hugo38rodrigues/GazSensorRobot/datasheet/MQ-2/mq2-arduino-curve-reading-rs-r0-ratio-calibration.png

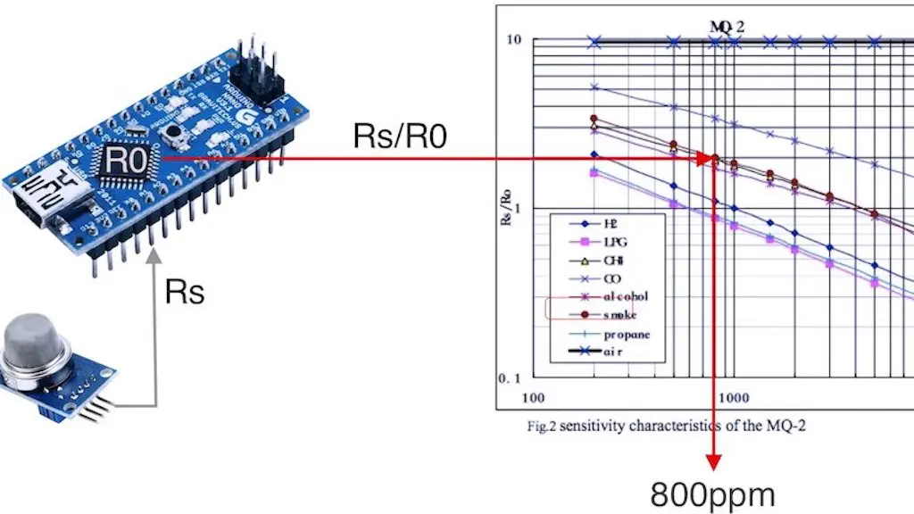
datasheet/MQ-2/mq2-arduino-curve-reading-rs-r0-ratio-calibration.png
