hugo38rodrigues/GazSensorRobot/pictures/20201014_091613.jpg

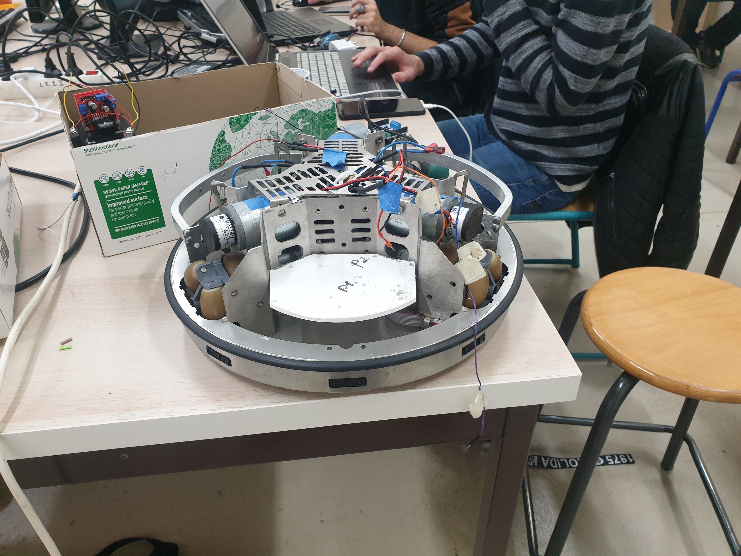
pictures/20201014_091613.jpg
