hugo38rodrigues/GazSensorRobot/Doc/Rapport_projet_2020_2021.docx

Rodrigues Hugo

Neyret Anthony

# Rapport de projet de fin d’étude

# Robot détecteur de Gaz

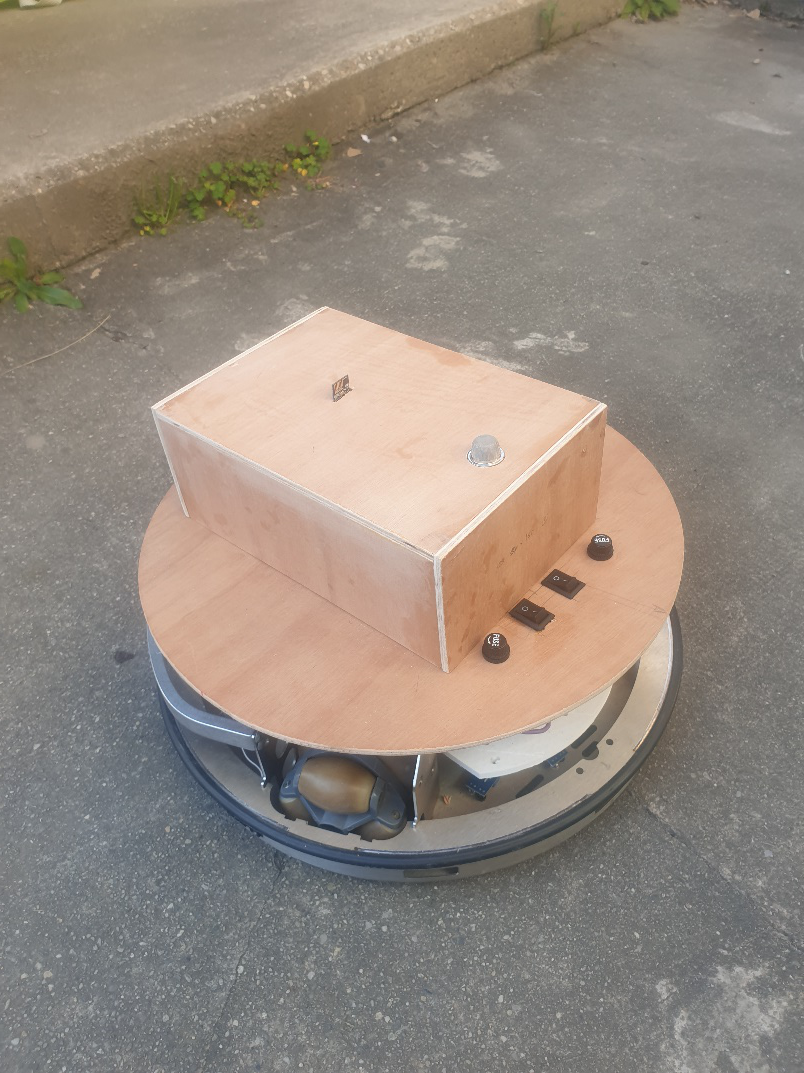
[picture p3: figure]

IUT GEII Le Creusot Année scolaire 2020 – 2021

# 1 Cahier des charges

## 1.1 Objectifs

L’objectif de ce projet a été de transformer un robot construit précédemment à l’IUT en un robot capable de se déplacer dans un environnement connu et détecter quelque chose.

Nous avons complété le cahier des charges avec les fonctions suivantes :

- Créer un robot mobile ayant pour but de trouver l’origine d’un gaz sur un terrain connu et le signaler à l’utilisateur par un mail.
- Le robot doit être dérivé d’une base de robot préexistant et fourni par l’IUT.
- Le robot sera alimenté par batterie (2 x 12V)
- Il devra disposer d’un mécanisme de détection de gaz et/ou fumée
- Il devra utiliser un système Wi-Fi pour transmettre l’information d’alerte via un mail.
- Il devra suivre un chemin prédéfini par une bande noire au sol.
- Il devra transmettre une photo/vidéo via une caméra de la zone de détection de gaz/fumées.
- Il devra stopper son parcours dès qu’il arrive dans sa zone de stockage (fin de parcours)
- Il devra stopper son parcours s’il rencontre un obstacle.

## 1.2 Présentation du robot

Il s’agit d’un robot construit à l’IUT les années précédentes avec :

- une armature en acier,
- trois roues avec moteurs disposées en étoile,
- deux supports de batterie,
- un capteur de contact digital présent sur tout le tour du robot,
- des capteurs de proximités analogiques positionnés autour du robot (9 capteurs).

Les trois moteurs fonctionnent et les roues tournent correctement en sens horaire et antihoraire suivant la tension d’alimentation (positive/négative).

Les deux batteries sont opérationnelles et disposent d’une tension de 12V chacune.

Note : Les batteries ne sont pas rechargeables.

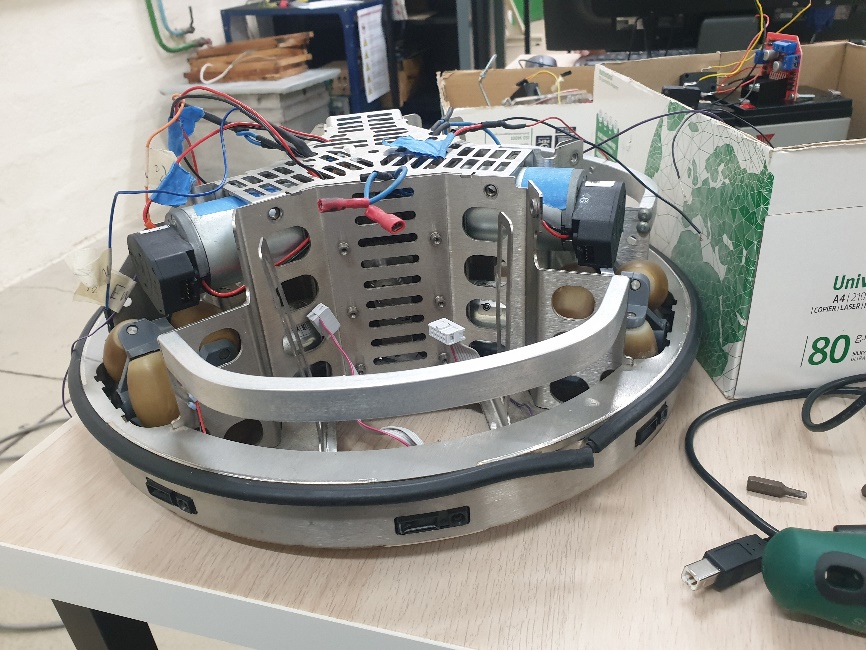
[picture p4: figure]

## 1.3 Matériel mis à disposition

L’IUT a fourni le matériel suivant pour la réalisation du robot :

- Le robot
- Les deux batteries de 12V
- Un microcontrôleur de type Arduino UNO
- Une caméra de type OpenMV H7
- Des câbles

## 1.4 Matériel acheté pour la réalisation

Afin de permettre la réalisation du projet, le matériel suivant a été acheté en complément, son utilisation sera détaillée par la suite :

- Un capteur de détection de gaz/fumée
- Trois capteurs digitaux de proximité à LED
- Un démultiplexeur de type 74HC595
- Des borniers (Dupont et à vis)
- Des câbles

# 2 Planning

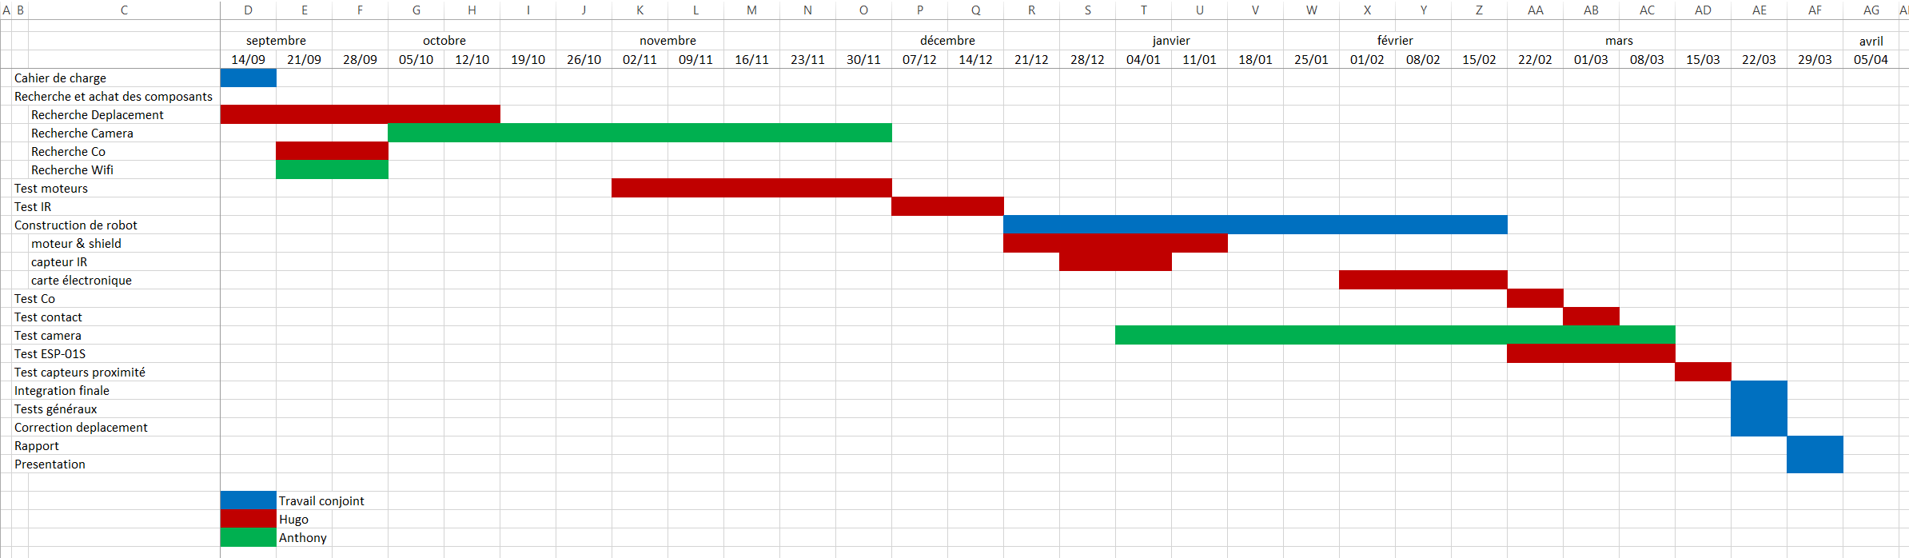
[picture p5: figure]

# 3 La conception

## 3.1 Les fonctions mises en œuvre

Les différentes fonctions mises en œuvre pour le robot sont :

- Le déplacement
- La détection de gaz/fumées
- La détection d’obstacles
- L’émission d’un mail d’avertissement en cas de détection de gaz/fumées.
- La gestion d’une zone de stockage

Voici une vue globale du montage réalisé :

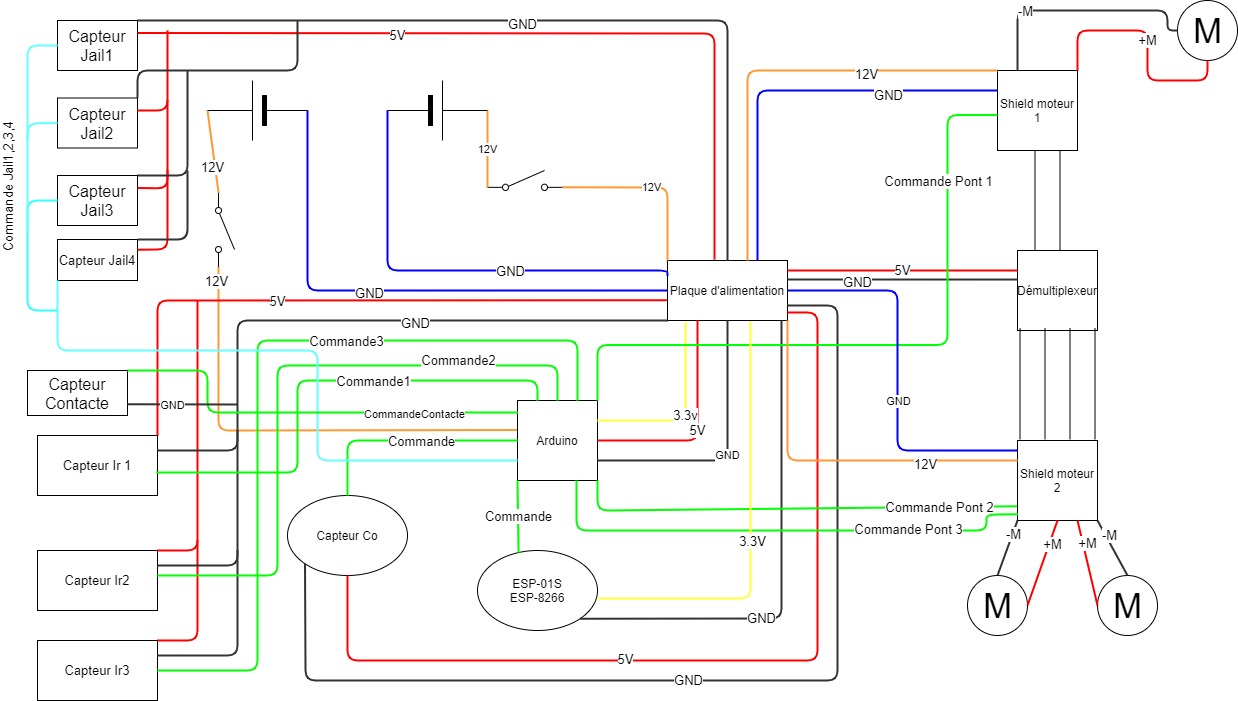
[picture p6: figure]

En orange, on distingue les composants en charge de gérer le déplacement, en jaune la détection de gaz, en vert la détection de contact, en violet l’envoi de mail et en bleu la zone de stockage.

### 3.1.1 La gestion du déplacement

Le robot est constitué de trois roues montées en étoile dont on pilote le sens la vitesse de rotation pour guider le robot.

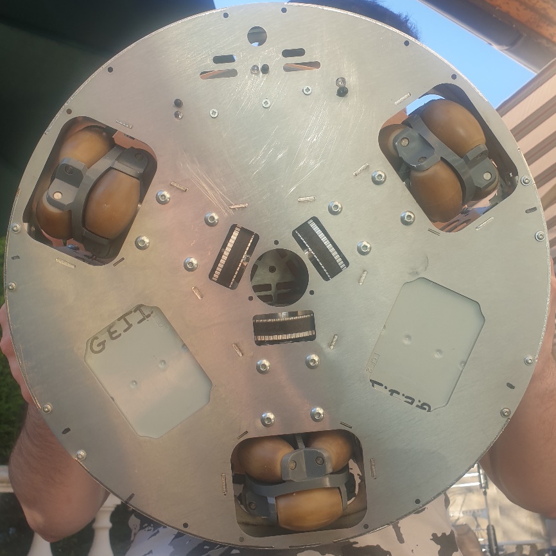
[picture p7: figure]

Le tableau suivant récapitule les actions à effectuer sur le robot pour gérer son déplacement :

| Roue 1 (avant droit) | Roue 2 (avant gauche) | Roue 3 (arrière)
Avancer | Sens horaire | Sens antihoraire | Stop
Ajuster à droite | Sens horaire | Sens antihoraire | Sens antihoraire
Ajuster à gauche | Sens horaire | Sens antihoraire | Sens horaire
Tourne à droite | Sens antihoraire | Sens antihoraire | Sens antihoraire
Tourne à gauche | Sens horaire | Sens horaire | Sens horaire
Stop | Stop | Stop | Stop

Afin de piloter les moteurs et gérer la trajectoire du robot, on a choisi d’utiliser des shields moteur et des capteurs Infra Rouge digitaux placés dans le nez du robot pour détecter la ligne noire.

Les capteurs IR digitaux sont détaillés dans le chapitre 4.4.1.

Pour choisir les bons cas pour suivre la ligne on a dressé un tableau logique des entrées et sorties inversés :

Entrées | | | Sorties
Capteur Gauche | Capteur Centre | Capteur Droit | D | G | Ad | Ag | Stop | Av
1 | 1 | 1 | 0 | 0 | 0 | 0 | 1 | 0
1 | 1 | 0 | 1 | 0 | 0 | 0 | 0 | 0
1 | 0 | 1 | 0 | 0 | 0 | 0 | 0 | 1
1 | 0 | 0 | 0 | 0 | 1 | 0 | 0 | 1
0 | 1 | 1 | 0 | 1 | 0 | 0 | 0 | 0
0 | 1 | 0 | x | x | x | x | x | x
0 | 0 | 1 | 0 | 0 | 0 | 1 | 0 | 1
0 | 0 | 0 | x | x | x | x | x | x

Les « 0 » représentent quand les capteurs IR détectent la ligne noire (absence de détection).

- D/G représente une rotation droite/gauche (le robot tourne sur place)
- Ad/Ag représente un ajustement droite / gauche (le robot continue d’avancer mais tourne en même temps grâce à la roue arrière)
- Stop : arrêt des moteurs
- Av : représente une avance du robot

### 3.1.2 Les Moteurs

Les moteurs intégrés dans le robot sont des GR42X25 :

- Tension nominale : 24V,
- Un courant nominal de 0.86A.
- Puissance nominale de 14.3W.

Nous avant fait le choix d’alimenter les moteurs en 12V afin de limiter la consommation sur les batteries (répartition de charges sur les deux batteries) et réduire la vitesse des moteurs.

### 3.1.3 Les Shields L298N

Afin de piloter les moteurs et gérer le sens de rotation, on a choisi de mettre en œuvre des shields moteur de type L298N qui intègrent un double pont en H.

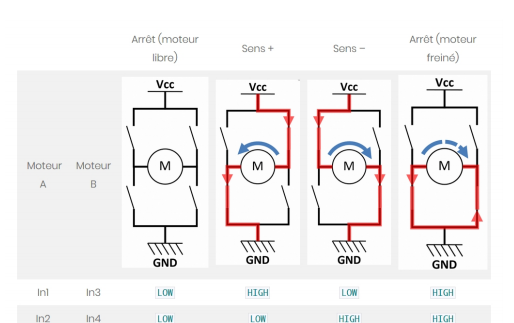
[picture p8: figure]

L’activation d’un pont en H (broches Enable ENA et ENB) ainsi que le sens de rotation des moteurs (broches In1 à In4) sont pilotés par l’Arduino. Ces broches d’activation sont des entrées PWM permettant ainsi de contrôler la vitesse de rotation du moteur.

On justifie le choix d’avoir pris des Shields par le fait que l’Arduino ne peut pas alimenter seul les moteurs (sortie Arduino 5V et max 40 mA).

Les broches permettant de gérer le sens de rotation sont câblées à l’Arduino par l’intermédiaire d’un démultiplexeur.

Les Shields sont alimentés par les batteries via une plaque d’alimentation en 12 V.

### 3.1.4 Démultiplexeur 74HC595

Lors de la conception, nous nous sommes rendu compte que nous allions manquer de pins digitales sur l’Arduino pour piloter les 2 Shields. Après réflexion et recherche sur Internet on a décidé d’opter pour l’ajout d’un démultiplexeur 74HC595N pour étendre le nombre de pins digitales disponibles plutôt que de rajouter un autre Arduino.

Le 74HC595 est en fait un registre à décalage qui reçoit en entrée une information sous la forme d’un champ de bits (codé sur 8 bits) et qui le transforme en 8 signaux parallèles (état haut ou bas) sur ses sorties Qn.

L’alimentation du démultiplexeur se fait par la plaque d’alimentation en 5V.

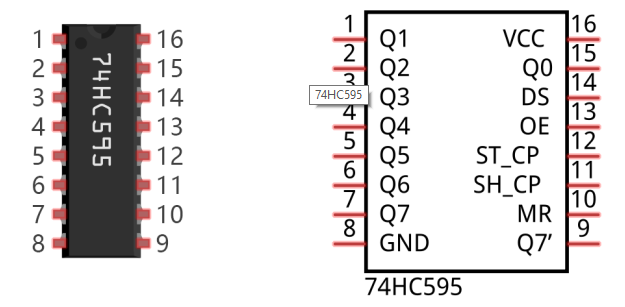
[picture p9: figure]

L’entrée des données issues de l’Arduino permettant de commander les sorties se trouve sur Serial Data Input (DS).

La modification de l’état de sortie du registre nécessite d’activer le Latch (ST_CP) que l’on passe à l’état bas. Une fois le registre reconfiguré, il est remis à l’état haut pour activer les sorties du registre.

Afin de savoir qu’une nouvelle donnée est disponible en lecture (sur la broche DS), le 74HC595 a besoin d’un front montant d’horloge Clock (SH_CP) qui est fournie par l’Arduino.

Une fois le Latch remis à l’état haut, les pins de sorties sont à l’image du champ de bits fourni en entrée sur la pin DS.

Pour chaque moteur, le sens de rotation horaire est codé sous la forme 01, alors que le sens antihoraire est codé sous la forme 10.

La pin Q0 n’est pas utilisée ainsi que la pin Q7 et sont mises à 0. Les valeurs pour la pin DS obtenues après un OU logique sont :

| M1 | M2 | M3 | DS
Avancer | 0b00100000 | 0b00010000 | 0b00000000 | 0b00110000
AjusteGauche | 0b00100000 | 0b00010000 | 0b00000010 | 0b00110010
AjusteDroite | 0b00100000 | 0b00010000 | 0b00000100 | 0b00110100
Gauche | 0b00100000 | 0b00001000 | 0b00000010 | 0b00101010
Droite | 0b01000000 | 0b00010000 | 0b00000100 | 0b01010100
Stop | N/A | N/A | N/A | N/A

## 3.2 Camera Open MV H7

La caméra utilisée est une caméra de chez OpenMV model H7, fournie avec le robot.

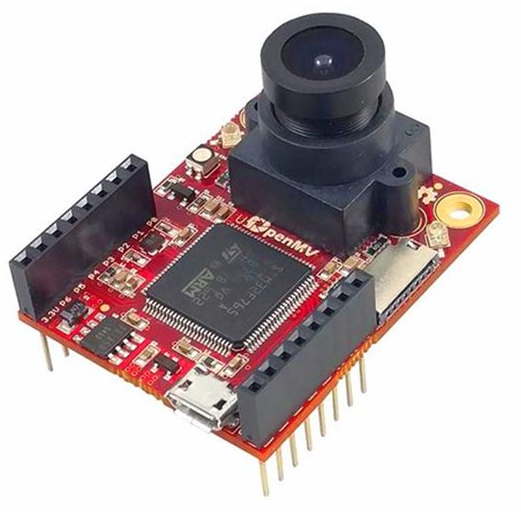
[picture p10: figure]

On avait pour but de faire communiquer la caméra et l’Arduino. Ce dernier devait détecter du gaz et demander à la caméra de prendre une photo, puis l’Arduino aurait récupéré cette photo pour l’envoyer par mail en Wifi.

Puis nous nous sommes orientés vers un envoi de la photo directement depuis la caméra grâce à un module Wifi. Malheureusement, la caméra OpenMV H7 ne supporte pas d’autres modules Wifi que l’extension Shield Wifi fourni par OpenMV. Il nous a donc été impossible de pouvoir transmettre les photos prises par la caméra avec le module Wifi ESP8266.01S que nous avions acheté.

Nous nous sommons penchés trop tard sur la fonction d’envoi des photos depuis la caméra et le tarif du Shield (30€) ainsi que les délais de livraison à quelques semaines de la fin du projet nous ont obligé à supprimer cette fonctionnalité.

Toutefois, pour régler ce problème, on a testé deux solutions pour le projet :

- La première solution consistait à utiliser notre module ESP-01S branché sur l’OpenMV et faire communiquer les deux. OpenMV fournit des librairies qui permettent de faire du transfert de données via des bus UART, I2C ou SPI qui auraient pu nous permettre de transférer les images octets par octets à l’Arduino ou à l’ESP-01S. Solution assez complexe et probablement impossible du fait du peu de mémoire disponible sur l’ESP.
- La deuxième solution a été d’acheter une caméra Arduino OV7670, mais nous avons trouvé très peu d’exemples de mise en œuvre ou alors avec d’autres version d’Arduino (la librairie Adafruit OV7670 n'est pas compatible avec un Arduino UNO mais avec un µcontroleur de gamme SADM et pas ATM32 comme le UNO).

Donc les deux solutions n’étaient pas viables et nous avons finalement choisit d’utiliser notre module ESP-01S pour envoyer uniquement un mail en cas de détection de gaz par le capteur MQ2.

## 3.3 Communication

Le module communication a été réalisé à l’aide d’un ESP8266-01S, qui a été programmé via les liaisons RX/TX de l’Arduino. Le code utilisé sur l’ESP-01 est disponible dans l’annexe 0.

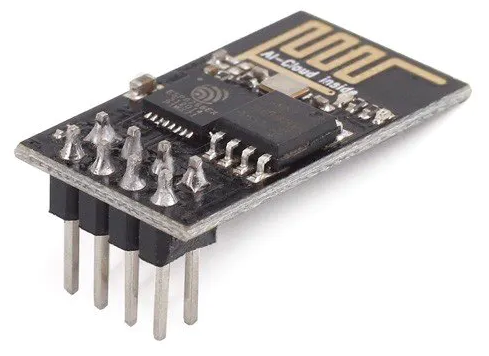
[picture p11: figure]

L’ESP8266-01S est activé par l’Arduino via la pin IO2. Lorsque l’ESP8266-01S est activé, il envoie un mail pour signaler que le robot a détecté du gaz.

Il est alimenté en 3.3V et cela passe également par la carte d’alimentation.

## 3.4 Les capteurs

A l’origine, le robot était équipé de deux types des capteurs différents :

- Un capteur digital de contact.
- 9 capteurs analogiques Infra Rouge de proximité.

En complément, nous avons ajouté au robot un capteur de gaz MQ-2 pour gérer la détection des gaz/fumées et 3 capteurs Infra Rouge digitaux pour détecter la ligne noire.

Les capteurs analogiques Infra Rouge sont utilisés pour détecter la zone de stockage du robot et le capteur de contact quant à lui est utilisé pour détecter un possible obstacle sur le chemin tracé.

### 3.4.1 Capteurs Infra Rouge de suivi de ligne

Afin de pouvoir effectuer le suivi de la ligne noire, nous avons acheté trois capteurs Infra Rouge digitaux pour Arduino.

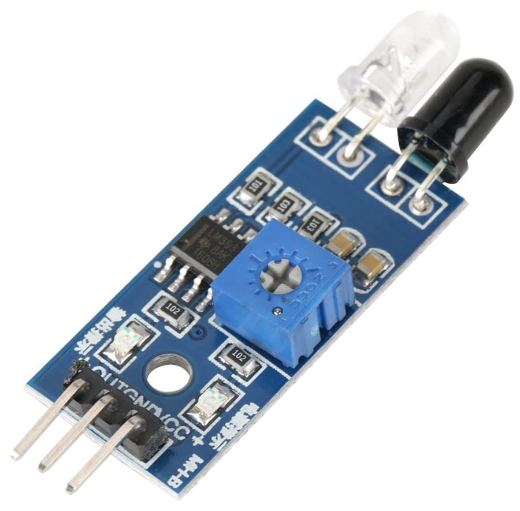
[picture p12: figure]

Ces capteurs fonctionnent sur une alimentation de 5V et son état est retourné sur une pin digitale à l’état haut en cas de détection.

La distance de mesure est ajustable à l’aide du potentiomètre intégré et la distance de détection est relativement faible, permettant ainsi leur usage sous le robot pour détecter la ligne noire.

La détection de la ligne noire est en fait une non-détection car l’Infra Rouge est absorbé par la couleur noire et donc non retournée au capteur qui ne voit pas d’obstacle.

### 3.4.2 Capteur de gaz

Afin de pouvoir détecter les gaz/fumées, nous avons acheté un capteur de gaz de type MQ-2.

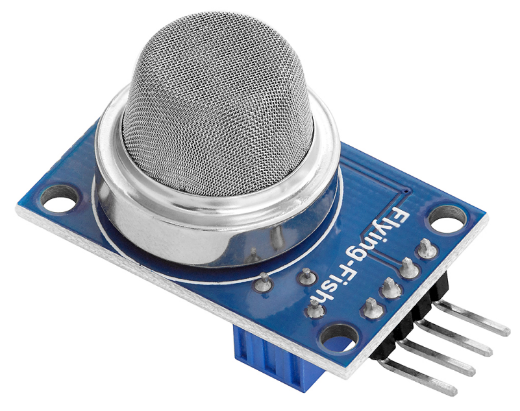
[picture p13: figure]

On a décidé de prendre ce capteur car sa gamme de détection nous offre des choix plutôt variés :


Comme on le voit sur le graphique, plusieurs types de gaz différents peuvent être détectés. A des fins de simplifications pour le projet, nous nous sommes contenté de lire la valeur renvoyée par le capteur sans mettre en œuvre la partie calibration et analyse du module (un exemple est disponible sur ce site : https://projetsdiy.fr/utiliser-detecteur-gaz-fumees-mq2-code-arduino/).

Le capteur dispose de deux sorties : une digitale qui renvoie un état haut en cas de détection basée sur un potentiomètre de réglage du seuil et une analogique qui renvoie simplement la valeur mesurée.

Nous avons fait le choix de prendre la sortie analogique car nous souhaitions contrôler un niveau de seuil de 300 ppm pour le CO, afin de préparer le terrain en vue de la mise en œuvre de la partie calibration/analyse. Nous avons fixé une valeur moyenne de détection en cas de présence de gaz de type briquet (butane) pour le projet.

### 3.4.3 Capteur de la zone de stockage :

Les capteurs Infrarouge montés d’origine sur le robot sont des capteurs analogiques de type GP2Y0A41SK0F. Ils répondent à la courbe de détection suivante :

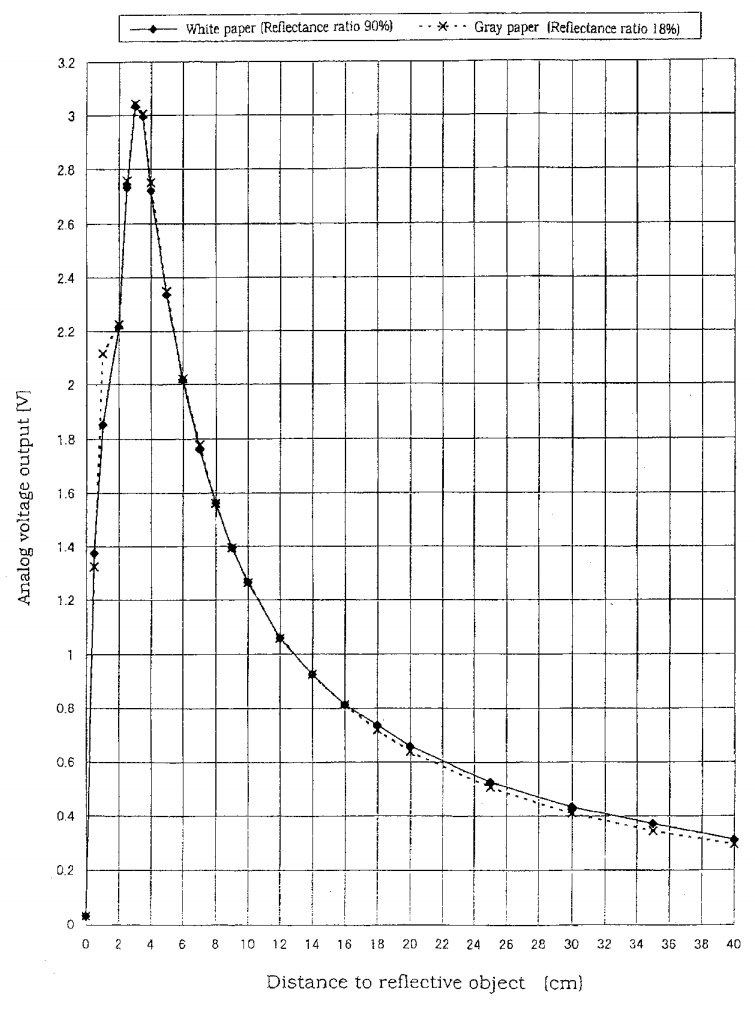
[picture p14: figure]

On distingue dans la courbe une zone d’incertitude liée à une trop grande proximité d’un obstacle avec le capteur. On a donc choisi de mettre un seuil de déclenchement à 18 cm, ce qui correspond à environ 0.7 V en sortie du capteur. C’est d’ailleurs pour cette raison que nous n’avons pas pu les utiliser comme capteurs de suivi de la ligne noire, la distance robot-sol étant de moins de 2 cm.

Afin de réutiliser les capteurs infra-rouges fournis, on a décidé de gérer une zone de stockage pour que le robot vienne se stationner lorsqu’il a fini son tour de ronde :

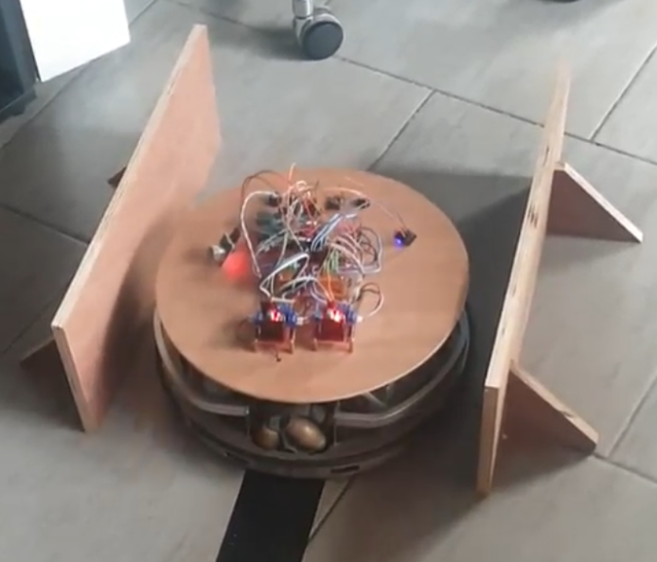
[picture p15: figure]

Le capteur est alimenté en 5V et relié à la masse sur la plaque d’alimentation.

Les pins de détection sont reliées à des pins analogiques de l’Arduino.

Lorsque 3 capteurs sur 4 détectent la zone de stockage à moins de 18 centimètres (zone seuil de détection), le robot s’arrête.

### 3.4.4 Capteur de contact

Le capteur de proximité d’obstacles est un capteur digital de contact qui se matérialise par une bande contact autour du robot qui est en fait un interrupteur normalement ouvert.

Il est branché sur une pin digitale de l’Arduino et sur la masse de la plaque d’alimentation.

Il fonctionne de telle sorte que quand il y a un objet sur le chemin du robot, le capteur rentre en contact avec l’obstacle et le robot s’arrête.

# 4 Conception des cartes électroniques

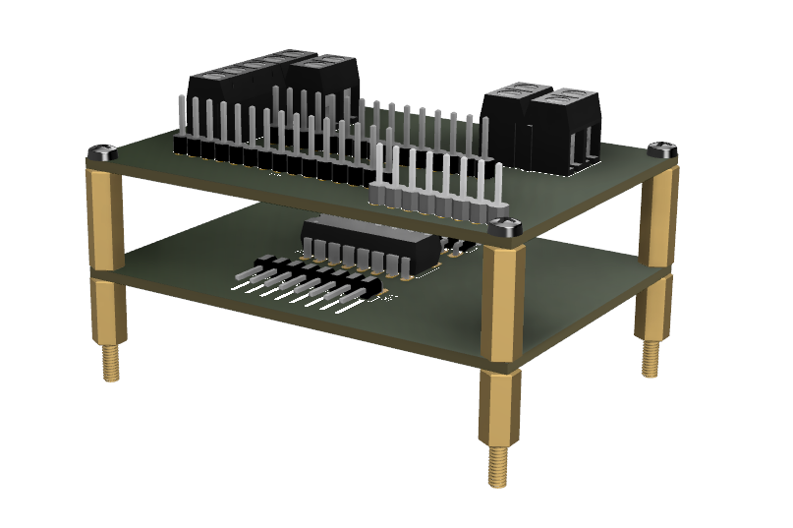
[picture p16: figure]

## 4.1 La carte d’alimentation

On a décidé de déporter les alimentations (12V, 3.3V, 5V et masse) de l’Arduino sur une carte d’alimentation complémentaire, afin de pallier au manque de pins disponibles sur l’Arduino.

La carte permet aussi d’alimenter les Shields moteur en 12V et l’Arduino en 12 V par la pin Vin.

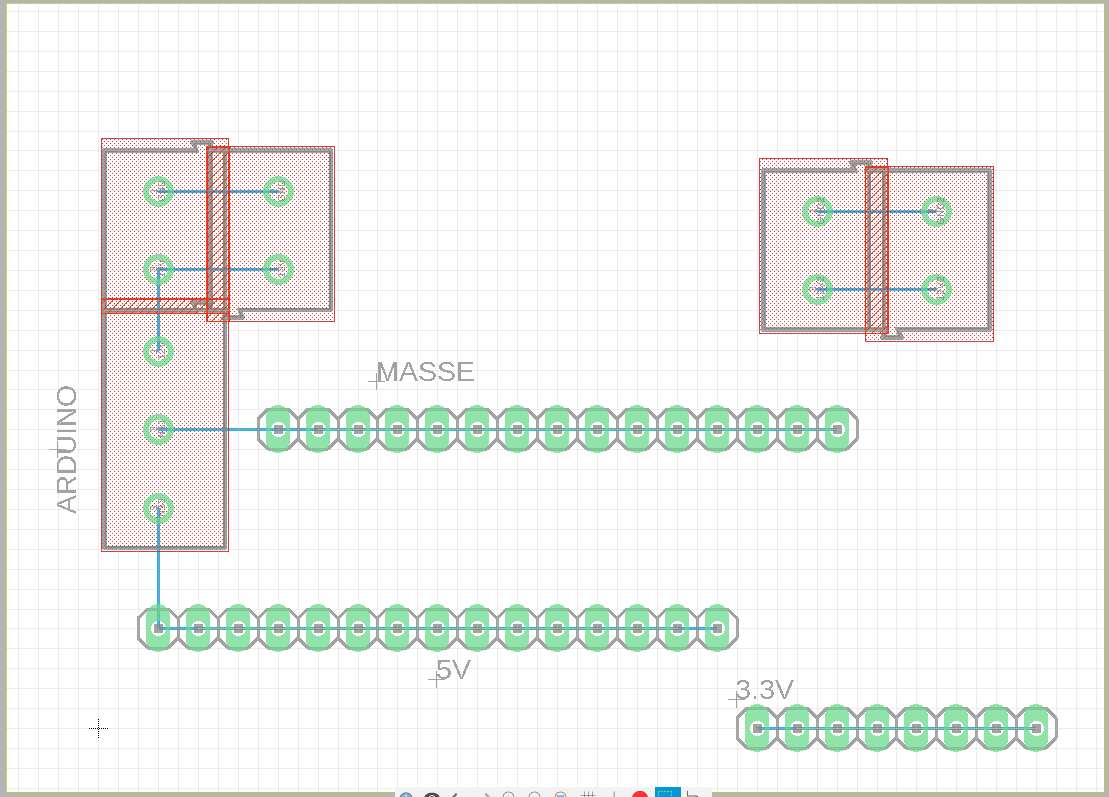
[picture p17: figure]

## 4.2 La carte d’extension pour le démultiplexeur

Cette carte permet simplement de câbler les différents ports du 74HC595.

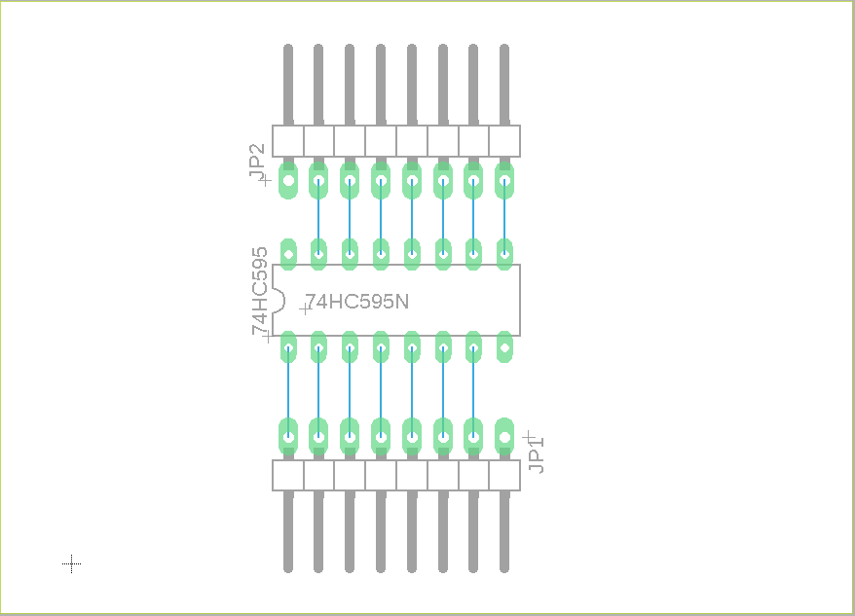
[picture p18: figure]

# 5 Conception et réalisation logicielle

Le microcontrôleur mis en œuvre étant un Arduino, nous avons donc codé le logiciel en C++.

Comme nous avions plusieurs modules à gérer, nous avons fait le choix de séparer le code entre le module de base, le « main » de l’Arduino nommé Deplacement_robot.ino et des classes écrites en C++, par exemple Robot.h et Robot.cpp, ceci afin de nous simplifier la tâche et découper le code en plus petits modules plus faciles à réaliser et à tester.

Nous avons donc modélisé les objets de la manière suivante dans un diagramme UML :

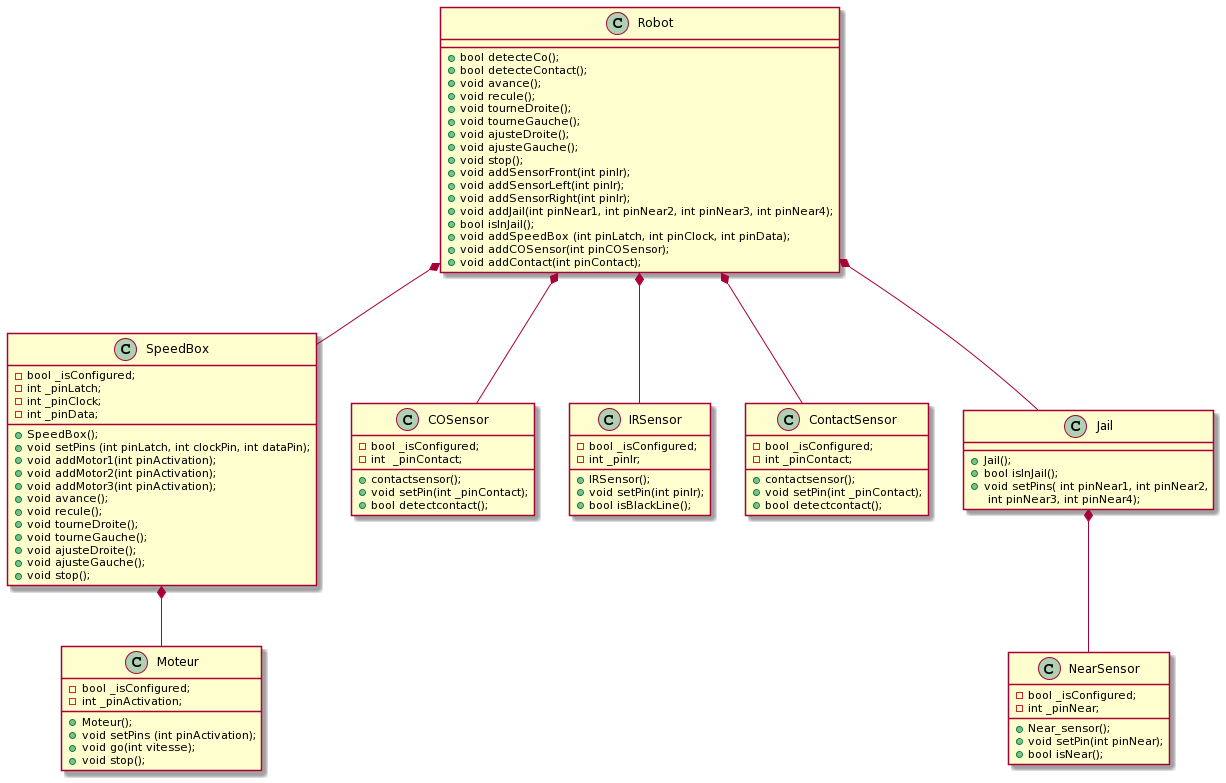
[picture p19: figure]

La classe Robot est la classe de base et elle modélise le robot avec ses différents capteurs et/ou fonctions.

A noter la présence d’une classe SpeedBox qui a été introduite à la suite de la mise en œuvre du démultiplexeur. En effet, chaque moteur ne peut pas être piloté séparément, typiquement on ne peut pas changer le sens de rotation d’un moteur car cela joue directement sur les autres moteurs (cf. chapitre 4.1.4). Il nous fallait donc disposer d’une classe intermédiaire permettant cette gestion centralisée sans pour autant que cela soit supporté par la classe Robot elle-même.

Il en va de même pour la classe Jail qui est une centralisation de l’état des différents capteurs de proximité et qui gère notamment la détection par 3 capteurs sur 4.

La partie envoi de mail n’est pas présente dans cette modélisation car il s’agit en fait d’un code différent, directement écrit en C++ dans un fichier de type .ino. Il est tiré d’une librairie : EMailSender library for Arduino.

Le code a été modifié pour permettre l’ajout du message et des paramètres d’envoi de mail :

- Nom du serveur SMTP (gmail)
- Identifiants d’envoi
- Sujet
- Message

Le code du programme principal est disponible à l’annexe 10.4, celui des classes à l’annexe 10.5 et enfin celui de l’ESP-01S à l’annexe 10.3.

# 6 Difficultés rencontrées :

## 6.1 Vitesse des moteurs

Lors du déplacement, dans les virages, les capteurs IR n’avaient pas le temps de capter la bande noire.

Nous avons dû ralentir les moteurs en abaissant la tension d’alimentation des moteurs en jouant sur la pin Enable du shield et la tension délivrée par le pin PWM de l’Arduino. De plus, chaque moteur dispose d’une résistance interne différente et nous avons dû adapter les tensions délivrées par l’Arduino moteur par moteur afin d’obtenir des tensions d’alimentation identiques et assurer ainsi des vitesses de rotation identiques.

## 6.2 Dérapage des roues

La grande inertie du robot et le sol glissant provoquaient des dérapages et empêchaient le robot de tourner correctement.

Nous avons dû ajouter les fonctions AjusterGauche et AjusterDroite ainsi qu’adapter l’algorithme de suivi de trajectoire afin d’aider le robot à mieux rester aligner avec les bandes noires.

## 6.3 Le module Wifi incompatible avec la caméra

Malgré les différentes solutions envisagées et testées, le matériel à disposition et le planning nous ont contraints à uniquement envoyer un mail et abandonner l’option d’envoi des images en pièces jointes.

# 7 Les améliorations possibles

Au niveau hardware :

- Acheter un Shield Wifi OpenMV pour faire fonctionner la caméra et envoyer des images, l’intégration avec l’Arduino pour déclencher la prise de vue se faisant via une pin déjà disponible (celle utilisée pour demander l’envoi du mail à l’ESP-01S.
- Changer les batteries pour des batteries rechargeables et créer une station de recharge dans la zone de stockage.
- Construire un carénage au robot.

Au niveau software :

- Mettre en œuvre l’algorithme de détection de gaz en utilisant une phase de calibration et d’analyse du gaz retourné par le capteur MQ-2.
- Ajouter dans le code de la zone de stockage un horodatage pour décider de la mise en route du robot et la fin de son cycle.
- Modifier le code du capteur d’obstacle pour que le robot contourne l’objet et continue sa mission
- Permettre de paramétrer les mails envoyés par l’ESP-01S, par exemple pour signaler qu’il y a un obstacle à enlever ou que le robot a fini sa ronde et se trouve dans sa zone de stockage et qu’il charge.

# 8 Conclusion

Pour conclure sur ce projet de fin d’année, il nous a permis de pouvoir comprendre les démarches d’un projet sur plusieurs mois, la gestion des contraintes de livraison et de la compatibilité des fournisseurs que l’on peut rencontrer dans une entreprise.

Cela nous a également amené à rechercher des solutions alternatives pour répondre à un cahier des charges quand la solution initiale ne fonctionne pas.

Nous avons également découvert la programmation sur des microcontrôleurs que nous n’utilisons pas régulièrement comme l’Arduino UNO et l’ESP8266-01S ainsi que la mise en œuvre de librairies en C++.

Nous avons également abordé divers sujets en lien avec le développement et le prototypage comme la conception 3D et électronique sous Fusion 360 pour la construction des cartes d’extension, le protocole de messagerie (SMTP), l’intégration à une carte Wifi, l’utilisation de GitHub, la modélisation UML…

# 9 Annexes

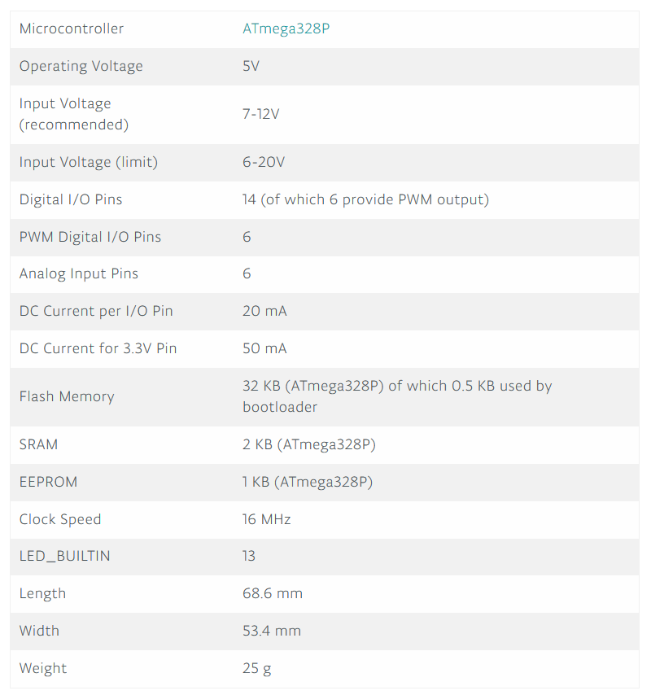
[picture p20: figure]

## 9.1 Arduino Uno

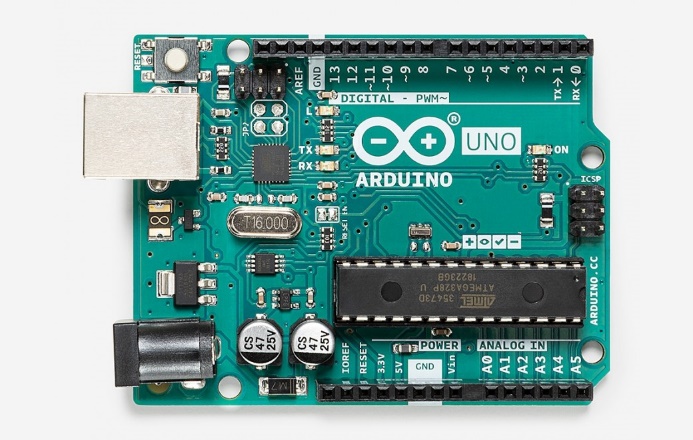
[picture p21: figure]

## 9.2 Shield Moteur L298N

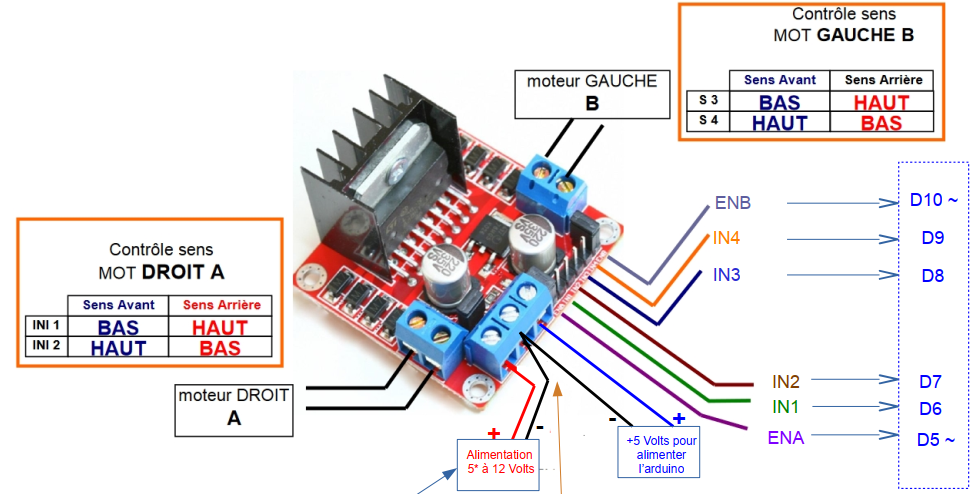
[picture p22: figure]

## 9.3 Le code de l’ ESP-01

/*

* EMailSender library for Arduino, esp8266 and esp32

* Simple esp32 Gmail send to a distribution list example

*

* https://www.mischianti.org/category/my-libraries/emailsender-send-email-with-attachments/

*

*/

#include "Arduino.h"

#include <EMailSender.h>

uint8_t connection_state = 0;

uint16_t reconnect_interval = 10000;

EMailSender emailSend("hugo38.test1@gmail.com", "toToeap1!");

uint8_t WiFiConnect(const char* nSSID = nullptr, const char* nPassword = nullptr)

{

static uint16_t attempt = 0;

Serial.print("Connecting to ");

if(nSSID) {

WiFi.begin(nSSID, nPassword);

Serial.println(nSSID);

}

uint8_t i = 0;

while(WiFi.status()!= WL_CONNECTED && i++ < 50)

{

delay(200);

Serial.print(".");

}

++attempt;

Serial.println("");

if(i == 51) {

Serial.print("Connection: TIMEOUT on attempt: ");

Serial.println(attempt);

if(attempt % 2 == 0)

Serial.println("Check if access point available or SSID and Password\r\n");

return false;

}

Serial.println("Connection: ESTABLISHED");

Serial.print("Got IP address: ");

Serial.println(WiFi.localIP());

return true;

}

void Awaits()

{

uint32_t ts = millis();

while(!connection_state)

{

delay(50);

if(millis() > (ts + reconnect_interval) && !connection_state){

connection_state = WiFiConnect();

ts = millis();

}

}

}

void SendMail(){

EMailSender::EMailMessage message;

message.subject = "Robot detection";

message.message = "Detection CO";

// Send email

const char* arrayOfEmail[] = {"hugo38.test1@gmail.com"};

EMailSender::Response resp = emailSend.send(arrayOfEmail, 1, message);

Serial.println("Sending status: ");

Serial.println(resp.status);

Serial.println(resp.code);

Serial.println(resp.desc);

}

void setup()

{

Serial.begin(115200);

const char* ssid = "Portablehugo";

const char* password = "0987654321";

connection_state = WiFiConnect(ssid, password);

if(!connection_state) // if not connected to WIFI

Awaits(); // constantly trying to connect

pinMode(2,INPUT_PULLUP);

}

void loop()

{

if(digitalRead(2) ==HIGH){

Serial.println("debut de sendmail");

SendMail();

}

delay(100);

}

## 9.4 Le code principal (Deplacement_robot.ino)

#include <Robot.h>

// Configuration des PIN Driver 1

const int pin_shie1d1_ENA = 10; // PWM Orange

const int pin_shie1d1_ENB = 0; // N/A

// Configuration des PIN Driver 2

const int pin_shie1d2_ENA = 3; // PWM Gris

const int pin_shie1d2_ENB = 5; // PWM Vert

// Configuration des PIN_IR

const int pin_IrFront = 7; // Orange

const int pin_IrLeft = 9; // Vert

const int pin_IrRight = 8; // Marron

// Configuration des PIN_NEAR

const int pin_NearRightFront = A1; //

const int pin_NearRightBack = A2; //

const int pin_NearLeftFront = A3; //

const int pin_NearLeftBack = A4; //

// Configuration des Pins du multiplexeur

const int pinLatch = 12; // Pin connected to ST_CP of 74HC595（Pin12）Orange

const int pinClock = 13; // Pin connected to SH_CP of 74HC595（Pin11）Blanc

const int pinData = 11; // Pin connected to DS of 74HC595（Pin14）Blanc

// Configuration des Pins du capteur Co et fumée

const int pinCOSensor = A0;

//Configuration des Pins du capteur de contacte

const int pinContactSensor =4;

//Configuration de la Pin du wifi

const int pinWifi = 2;

Robot robot = Robot();

bool turnRight=false;

bool turnLeft=false;

void setup()

{

Serial.begin(9600);

Serial.println("Setup configuration");

// Creation du capteur

robot.addCOSensor(pinCOSensor);

// Creation du wifi

Serial.println("Creation du module wifi");

pinMode(pinWifi,OUTPUT);

digitalWrite(pinWifi,LOW);

// Creation de la boite de vitesse

Serial.println("Creation de la boite de vitesse");

robot.addSpeedBox(pinLatch, pinClock, pinData);

robot.speedBox.addMotor1(pin_shie1d1_ENA); // Moteur gauche

robot.speedBox.addMotor2(pin_shie1d2_ENA); // Moteur droit

robot.speedBox.addMotor3(pin_shie1d2_ENB); // Moteur arrière

Serial.println("Ajout des capteurs IR");

robot.addSensorFront(pin_IrFront);

robot.addSensorLeft(pin_IrLeft);

robot.addSensorRight(pin_IrRight);

Serial.println("Ajout des capteurs de la prison");

robot.addJail(pin_NearRightFront, pin_NearRightBack, pin_NearLeftFront, pin_NearLeftBack);

Serial.println("ajout du capteur contacte");

robot.addContact(pinContactSensor);

Serial.println("Robot prêt... Attente 2\"");

robot.stop();

delay(2000);

}

void loop() {

Serial.println ("#### Start new loop");

digitalWrite(pinWifi,LOW);

if ((robot.isInJail() || robot.detecteContact()))

{

Serial.println("Robot en prison... Stop ou capteur touché");

robot.stop();

}

else if (robot.detecteCo())

{

Serial.println("Détection de CO ou de fumée");

robot.stop();

Serial.println("send mail");

digitalWrite(pinWifi,HIGH);

delay(150);

digitalWrite(pinWifi,LOW);

while(true) {

Serial.println("Le robot est bloqué, faire intervenir un technicien");

delay(10000);

}

}

else {

if(robot.IRSensorRight.isBlackLine()){

Serial.println("Détection d'une ligne à droite");

turnRight=true;

turnLeft=false;

robot.ajusteDroite();

}

if(robot.IRSensorLeft.isBlackLine()){

Serial.println("Détection d'une ligne à gauche");

turnRight=false;

turnLeft=true;

robot.ajusteGauche();

}

if(robot.IRSensorFront.isBlackLine()) {

Serial.println("Détection d'une ligne devant");

robot.avance();

}

else {

Serial.println("Aucune ligne détectée devant, arrêt du robot");

if (turnLeft){

Serial.println("Rotation vers la gauche");

robot.tourneGauche();

}

else if (turnRight){

robot.tourneDroite();

Serial.println("Rotation vers la gauche");

}

}

}

delay(20);

}

## 9.5 Les classes C++

### 9.5.1 contactsensor.h

/*

* Contactsensor.h - Librairie de gestion d'un capteur de contacte

* Créé par Hugo Rodrigues/Anthony Neyret - 03/03/2020

*/

#ifndef CONTACTSENSOR_H

#define CONTACTSENSOR_H

#include "Arduino.h"

class contactsensor

{

public:

contactsensor();

void setPin(int _pinContact);

bool detectcontact();

private:

bool _isConfigured;

int _pinContact;

};

#endif // CONTACTSENSOR_H

### 9.5.2 contactsensor.cpp

/*

* Contactsensor.h - Librairie de gestion d'un capteur de contacte

* Créé par Hugo Rodrigues/Anthony Neyret - 03/03/2020

*/

#include "contactsensor.h"

#include "Arduino.h"

contactsensor::contactsensor()

{

_isConfigured = false;

}

void contactsensor::setPin(int pinContact){

pinMode (pinContact, INPUT_PULLUP);

_pinContact=pinContact;

_isConfigured = true;

}

bool contactsensor::detectcontact(){

if (_isConfigured && !digitalRead(_pinContact))

return true;

else

return false;

}

### 9.5.3 cosensor.h

/*

* Co.h - Librairie de gestion d'un capteur CO

* Créé par Hugo Rodrigues/Anthony Neyret - 12/02/2020

*/

#ifndef COSENSOR_H

#define COSENSOR_H

#include "Arduino.h"

class COSensor{

public:

COSensor();

void setPin(int pinSensor);

bool detecteCo();

void calibCo();

private:

bool _isConfigured;

int _pinSensor;

};

#endif // COSENSOR_H

### 9.5.4 cosensor.cpp

/*

* Co.cpp - Librairie de gestion d'un capteur CO

* Créé par Hugo Rodrigues/Anthony Neyret - 12/02/2020

*/

#include "cosensor.h"

#include "Arduino.h"

COSensor::COSensor()

{

_isConfigured = false;

}

void COSensor::setPin(int pinSensor){

pinMode (pinSensor, INPUT);

_pinSensor=pinSensor;

_isConfigured = true;

}

bool COSensor::detecteCo(){

int val = analogRead (_pinSensor);

Serial.println("valeur CO:" + String(val));

if (_isConfigured && val > 350)

return true;

else

return false;

}

### 9.5.5 IRSensor.h

/*

* IRSensor.h - Librairie de gestion d'un capteur IR

* Créé par Hugo Rodrigues/Anthony Neyret - 14/02/2021

*/

#ifndef Sensor_h

#define Sensor_h

#include "Arduino.h"

class IRSensor {

public :

IRSensor();

void setPin(int pinIr);

bool isBlackLine();

private :

bool _isConfigured;

int _pinIr;

};

#endif

### 9.5.6 IRSensor.cpp

/*

* IRSensor.cpp - Librairie de gestion d'un capteur IR

* Créé par Hugo Rodrigues/Anthony Neyret - 14/02/2021

*/

#include "Arduino.h"

#include "IRSensor.h"

IRSensor::IRSensor(){

_isConfigured = false;

}

void IRSensor::setPin(int pinIr){

pinMode (pinIr, INPUT);

_pinIr=pinIr;

_isConfigured = true;

}

bool IRSensor::isBlackLine(){

if (_isConfigured && digitalRead(_pinIr)==HIGH)

return true;

else

return false;

}

### 9.5.7 jail.h

/*

* Jail.h - Librairie de gestion de la prison

* Créé par Hugo Rodrigues/Anthony Neyret - 14/02/2021

*/

#ifndef JAIL_H

#define JAIL_H

#include "Near_sensor.h"

class Jail{

public:

Jail();

bool isInJail();

void setPins(int pinNear1, int pinNear2, int pinNear3, int pinNear4);

private:

Near_sensor _Near_sensor1;

Near_sensor _Near_sensor2;

Near_sensor _Near_sensor3;

Near_sensor _Near_sensor4;

bool _isConfigured;

};

#endif // JAIL_H

### 9.5.8 jail.cpp

/*

* Jail.cpp - Librairie de gestion de la prison

* Créé par Hugo Rodrigues/Anthony Neyret - 14/02/2021

*/

#include "jail.h"

#include "Arduino.h"

Jail::Jail(){

_isConfigured = false;

_Near_sensor1 = Near_sensor();

}

void Jail::setPins(int pinNear1, int pinNear2, int pinNear3, int pinNear4){

_Near_sensor1.setPin(pinNear1);

_Near_sensor2.setPin(pinNear2);

_Near_sensor3.setPin(pinNear3);

_Near_sensor4.setPin(pinNear4);

_isConfigured = true;

}

bool Jail::isInJail(){

int compteur=0;

if (_Near_sensor1.isNear())

compteur++;

if (_Near_sensor2.isNear())

compteur++;

if (_Near_sensor3.isNear())

compteur++;

if (_Near_sensor4.isNear())

compteur++;

if(_isConfigured && compteur>=3) {

Serial.println("3 capteurs sur4 détectent la prison");

return true;

}

else

return false;

}

### 9.5.9 Moteur.h

/*

* Moteur.h - Librairie de gestion d'un moteur DC

* Créé par Hugo Rodrigues/Anthony Neyret - 26/12/2020

*/

#ifndef Moteur_h

#define Moteur_h

#include "Arduino.h"

class Moteur {

public :

Moteur();

void setPins (int pinActivation);

void go(int vitesse);

void stop();

private :

bool _isConfigured;

int _pinActivation;

};

#endif

### 9.5.10 Moteur.cpp

/*

* Moteur.cpp - Librairie de gestion d'un moteur DC

* Créé par Hugo Rodrigues/Anthony Neyret - 26/12/2020

*/

#include "Arduino.h"

#include "Moteur.h"

Moteur::Moteur(){

_isConfigured = false;

}

void Moteur::setPins(int pinActivation){

// Configuration des pins moteur

// Utilisation de pin PWM pour contrôler la vitesse des moteurs

pinMode (pinActivation, OUTPUT);

_pinActivation = pinActivation;

_isConfigured = true;

}

void Moteur::go(int vitesse) {

if (_isConfigured) {

Serial.println ("Go motor, speed"+String(vitesse)+"%");

// Vitesse de 80%

analogWrite(_pinActivation, map (vitesse, 0, 100, 0, 255));

}

}

void Moteur::stop() {

if (_isConfigured) {

Serial.println("Stop motor");

// Stop moteur

analogWrite(_pinActivation, 0);

}

}

### 9.5.11 Near_sensor.h

#ifndef NEAR_SENSOR_H

#define NEAR_SENSOR_H

#include "Arduino.h"

class Near_sensor{

public :

Near_sensor();

void setPin(int pinNear);

bool isNear();

private :

bool _isConfigured;

int _pinNear;

};

#endif // NEAR_SENSOR_H

### 9.5.12 Near_sensor.cpp

/*

*Near_Sensor.cpp - Librairie de gestion d'un capteur Ir de proximité

* Créé par Hugo Rodrigues/Anthony Neyret - 14/02/2021

*/

#include "Arduino.h"

#include "Near_sensor.h"

Near_sensor::Near_sensor(){

_isConfigured = false;

}

void Near_sensor::setPin(int pinNear){

pinMode (pinNear, INPUT);

_pinNear=pinNear;

_isConfigured = true;

}

bool Near_sensor::isNear(){

//d'apres l abbaque 0.7V correspond à 18 cm

if (_isConfigured && analogRead(_pinNear) > 1023*0.7/5)

return true;

else

return false;

}

### 9.5.13 SpeedBox.h

/*

* SpeedBox.h - Librairie de gestion de la boite de vitesses contrôlant le sens des moteurs

* La boite de vitesse s'appuie sur un multiplexeur de type 74HC595

* Créé par Hugo Rodrigues/Anthony Neyret - 26/12/2020

*/

#ifndef SpeedBox_h

#define SpeedBox_h

#include "Arduino.h"

#include "Moteur.h"

class SpeedBox {

public :

SpeedBox();

void setPins (int pinLatch, int clockPin, int dataPin);

void addMotor1(int pinActivation);

void addMotor2(int pinActivation);

void addMotor3(int pinActivation);

void avance();

void recule();

void tourneDroite();

void tourneGauche();

void ajusteDroite();

void ajusteGauche();

void stop();

private :

bool _isConfigured;

int _pinLatch;

int _pinClock;

int _pinData;

Moteur _moteur1;

Moteur _moteur2;

Moteur _moteur3;

// Bits 5 et 6 gère le sens de rotation du moteur 1

// 5 LOW, 6 HIGH : Sens rotation horaire

// 5 HIGH, 6 LOW : Sens rotation anti-horaire

int _moteur1Horaire = 0b00100000 ; // Q6 sur le 74HC595

int _moteur1AntiHoraire =0b01000000; // Q5 sur le 74HC595

// Bits 3 et 4 gère le sens de rotation du moteur 2

// 4 LOW, 3 HIGH : Sens rotation horaire

// 4 HIGH, 3 LOW : Sens rotation anti-horaire

int _moteur2Horaire = 0b00001000; // Q4 sur le 74HC595

int _moteur2AntiHoraire = 0b00010000; // Q3 sur le 74HC595

// Bits 1 et 2 gère le sens de rotation du moteur 3

// 2 LOW, 1 HIGH : Sens rotation horaire

// 2 HIGH, 1 LOW : Sens rotation anti-horaire

int _moteur3Horaire = 0b00000010; // Q2 sur le 74HC595

int _moteur3AntiHoraire = 0b00000100; // Q1 sur le 74HC595

void UpdateMutex(int data);

};

#endif

### 9.5.14 SpeedBox.cpp

/*

* SpeedBox.cpp - Librairie de gestion de la boite de vitesses contrôlant le sens des moteurs

* La boite de vitesse s'appuie sur un multiplexeur de type 74HC595

* Créé par Hugo Rodrigues/Anthony Neyret - 26/12/2020

*/

#include "Arduino.h"

#include "Moteur.h"

#include "SpeedBox.h"

SpeedBox::SpeedBox() {

_isConfigured = false;

_moteur1 = Moteur();

_moteur2 = Moteur();

_moteur3 = Moteur();

_pinLatch = 0;

_pinClock = 0;

_pinData = 0;

}

void SpeedBox::setPins (int pinLatch, int pinClock, int pinData) {

// Configuration des pins moteur

// Utilisation de pin PWM pour contrôler la vitesse des moteurs

pinMode (pinLatch, OUTPUT);

pinMode (pinClock, OUTPUT);

pinMode (pinData, OUTPUT);

_pinLatch = pinLatch;

_pinClock = pinClock;

_pinData = pinData;

_isConfigured = true;

}

void SpeedBox::addMotor1(int pinActivation) {

_moteur1.setPins (pinActivation);

}

void SpeedBox::addMotor2(int pinActivation) {

_moteur2.setPins (pinActivation);

}

void SpeedBox::addMotor3(int pinActivation) {

_moteur3.setPins (pinActivation);

}

void SpeedBox::avance() {

// Set moteur1horaire + moteur2anti_horaire;

UpdateMutex(_moteur1Horaire | _moteur2AntiHoraire | _moteur3Horaire);

Serial.println("moteur 1");

_moteur1.go(92);

Serial.println("moteur 2");

_moteur2.go(65);

Serial.println("moteur 3");

_moteur3.stop();

}

void SpeedBox::recule() {

// Set moteur1antihoraire + moteur2horaire;

UpdateMutex(_moteur1AntiHoraire | _moteur2Horaire | _moteur3Horaire);

_moteur1.go(60);

_moteur2.go(60);

_moteur3.stop();

}

void SpeedBox::ajusteDroite(){

// Set moteur123antihoraire +

UpdateMutex(_moteur1Horaire | _moteur2AntiHoraire| _moteur3AntiHoraire);

Serial.println("moteur 1");

_moteur1.go(92);

Serial.println("moteur 2");

_moteur2.go(65);

Serial.println("moteur 3");

_moteur3.go(80);

}

void SpeedBox::tourneDroite(){

// Set moteur123antihoraire +

UpdateMutex(_moteur1AntiHoraire | _moteur2AntiHoraire| _moteur3AntiHoraire);

Serial.println("moteur 1");

_moteur1.go(92);

Serial.println("moteur 2");

_moteur2.go(65);

Serial.println("moteur 3");

_moteur3.go(80);

}

void SpeedBox::tourneGauche(){

// Set moteur123horaire +

UpdateMutex(_moteur1Horaire | _moteur2Horaire | _moteur3Horaire);

Serial.println("moteur 1");

_moteur1.go(92);

Serial.println("moteur 2");

_moteur2.go(65);

Serial.println("moteur 3");

_moteur3.go(80);

}

void SpeedBox::ajusteGauche(){

// Set moteur123horaire +

UpdateMutex(_moteur1Horaire | _moteur2AntiHoraire | _moteur3Horaire);

Serial.println("moteur 1");

_moteur1.go(92);

Serial.println("moteur 2");

_moteur2.go(65);

Serial.println("moteur 3");

_moteur3.go(80);

}

void SpeedBox::stop(){

Serial.println("moteur 1");

_moteur1.stop();

Serial.println("moteur 2");

_moteur2.stop();

Serial.println("moteur 3");

_moteur3.stop();

}

void SpeedBox::UpdateMutex(int data) {

Serial.print("data for mutex: 0b");

Serial.print(data, BIN);

Serial.print(" (0x");

Serial.print(data, HEX);

Serial.println(")");

// On désactive le 74HC595

digitalWrite(_pinLatch, LOW);

// Mise à jour du registre à décalage

shiftOut(_pinData, _pinClock, MSBFIRST, data);

// On active le 74HC595

digitalWrite(_pinLatch, HIGH);

}

### 9.5.15 Robot.h

/*

* Robot.h - Librairie de gestion du robot

* Créé par Hugo Rodrigues/Anthony Neyret - 26/12/2020

*/

#ifndef Robot_h

#define Robot_h

#include "Arduino.h"

#include "IRSensor.h"

#include "Near_sensor.h"

#include "jail.h"

#include "SpeedBox.h"

#include "cosensor.h"

#include "contactsensor.h"

class Robot {

public :

Robot ();

bool detecteCo();

bool detecteContact();

void avance();

void recule();

void tourneDroite();

void tourneGauche();

void Robot::ajusteDroite();

void Robot::ajusteGauche();

void stop();

void addSensorFront(int pinIr);

void addSensorLeft(int pinIr);

void addSensorRight(int pinIr);

void addJail(int pinNear1, int pinNear2, int pinNear3, int pinNear4);

bool isInJail();

void addSpeedBox (int pinLatch, int pinClock, int pinData);

void addCOSensor(int pinCOSensor);

void addContact(int pinContact);

IRSensor IRSensorFront;

IRSensor IRSensorLeft;

IRSensor IRSensorRight;

SpeedBox speedBox;

COSensor _COSensor;

contactsensor _ContactSensor;

private :

Jail _jail;

};

#endif

### 9.5.16 Robot.cpp

/*

* Robot.cpp- Librairie de gestion du Robot

* Créé par Hugo Rodrigues/Anthony Neyret - 26/12/2020

*/

#include "Arduino.h"

#include "Robot.h"

#include "Moteur.h"

#include "IRSensor.h"

#include "Near_sensor.h"

#include "jail.h"

#include "SpeedBox.h"

#include "cosensor.h"

#include "contactsensor.h"

Robot::Robot() {

IRSensorFront = IRSensor();

IRSensorLeft = IRSensor();

IRSensorRight = IRSensor();

_jail = Jail();

speedBox = SpeedBox();

_COSensor = COSensor();

_ContactSensor = contactsensor();

}

void Robot::addContact(int pinContact){

_ContactSensor.setPin(pinContact);

}

void Robot::addCOSensor(int pinCOSensor){

_COSensor.setPin(pinCOSensor);

}

void Robot::addSpeedBox (int pinLatch, int pinClock, int pinData) {

speedBox.setPins(pinLatch, pinClock, pinData);

}

void Robot::addJail(int pinNear1, int pinNear2, int pinNear3, int pinNear4){

_jail.setPins(pinNear1, pinNear2, pinNear3, pinNear4);

}

void Robot::addSensorFront(int pinIr){

IRSensorFront.setPin(pinIr);

}

void Robot::addSensorLeft(int pinIr){

IRSensorLeft.setPin(pinIr);

}

void Robot::addSensorRight(int pinIr){

IRSensorRight.setPin(pinIr);

}

bool Robot::detecteContact(){

return _ContactSensor.detectcontact();

}

bool Robot::detecteCo(){

return _COSensor.detecteCo();

}

void Robot::avance() {

speedBox.avance();

}

void Robot::recule() {

speedBox.recule();

}

void Robot::tourneDroite() {

speedBox.tourneDroite();

}

void Robot::tourneGauche() {

speedBox.tourneGauche();

}

void Robot::ajusteDroite() {

speedBox.ajusteDroite();

}

void Robot::ajusteGauche() {

speedBox.ajusteGauche();

}

void Robot::stop() {

speedBox.stop();

}

bool Robot::isInJail() {

return _jail.isInJail();

}

IUT GEII Le Creusot Année scolaire 2020-2021 Page 4 sur 41

IUT GEII Le Creusot Année scolaire 2020-2021 Page 5 sur 41

IUT GEII Le Creusot Année scolaire 2020-2021 Page 6 sur 41

Rapport de projet de fin d’étude H.Rodrigues / A.Neyret
