hugo38rodrigues/GazSensorRobot/datasheet/L298N/cablage L298N.png

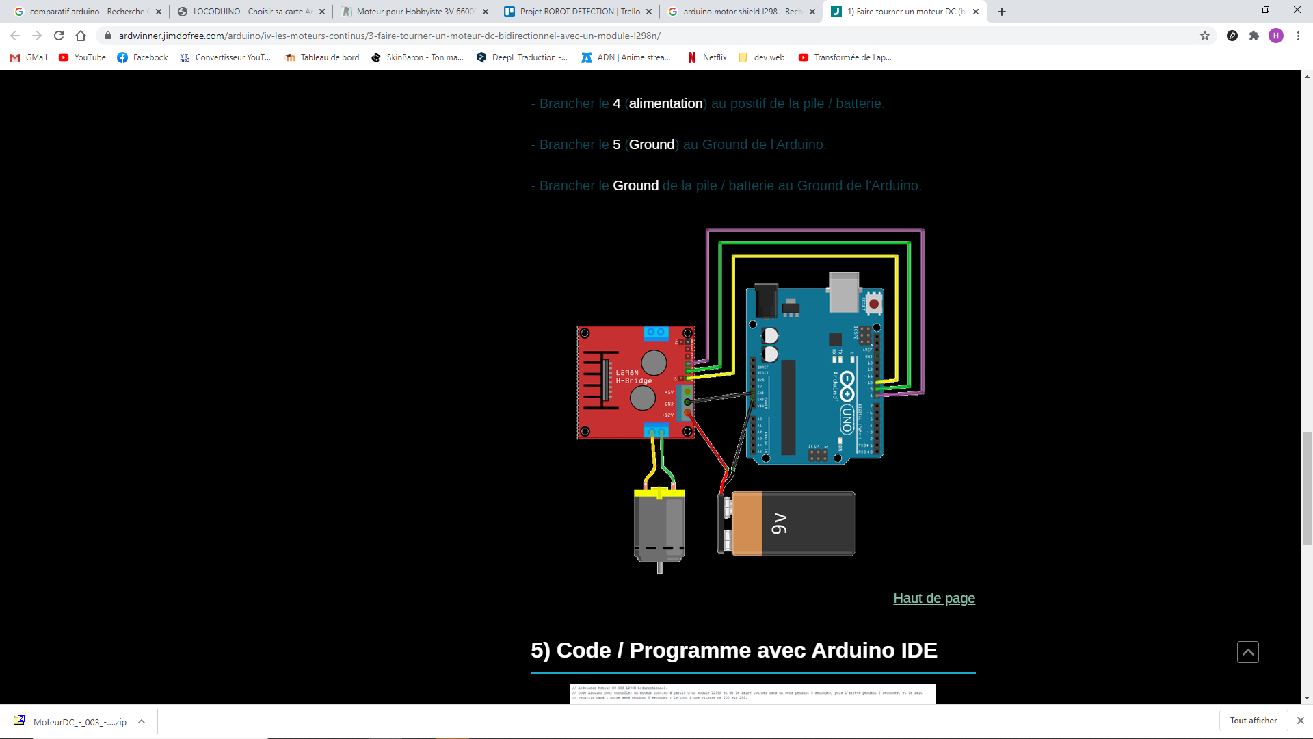
datasheet/L298N/cablage L298N.png
