hugo38rodrigues/GazSensorRobot/pictures/20201014_091606.jpg

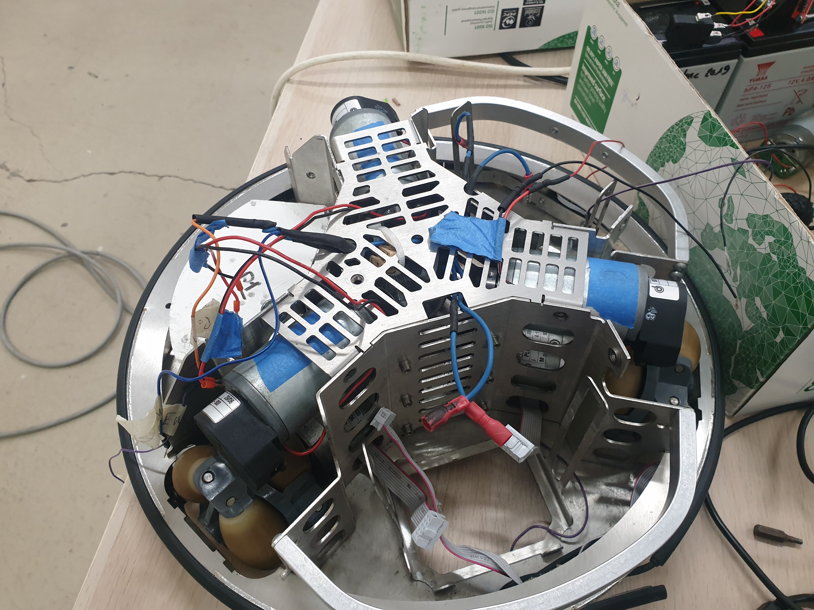
pictures/20201014_091606.jpg
