hugo38rodrigues/GazSensorRobot/pictures/20201014_091618.jpg

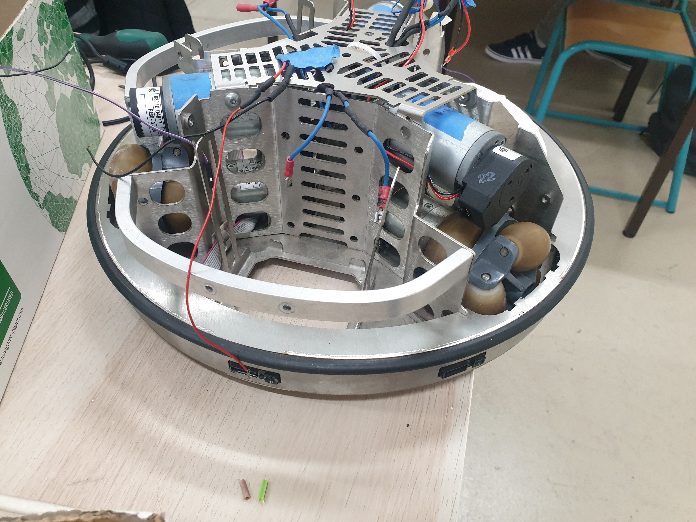
pictures/20201014_091618.jpg
