hugo38rodrigues/GazSensorRobot/pictures/20201014_091734.jpg

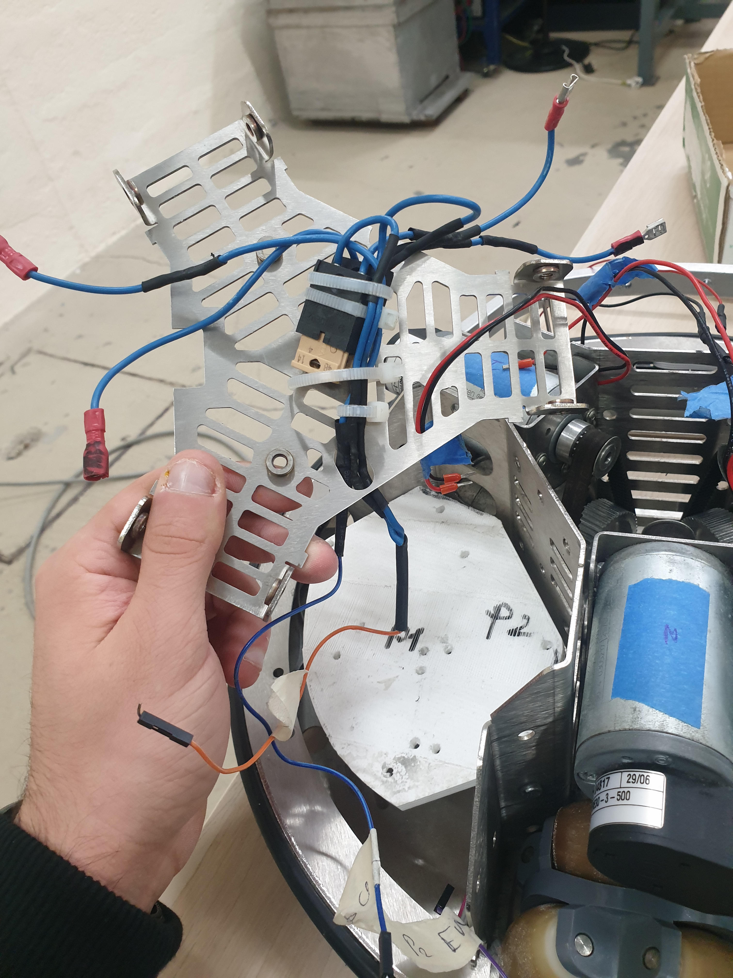
pictures/20201014_091734.jpg
