hugo38rodrigues/GazSensorRobot/electronic_schema/schema_cablage _v6.pdf

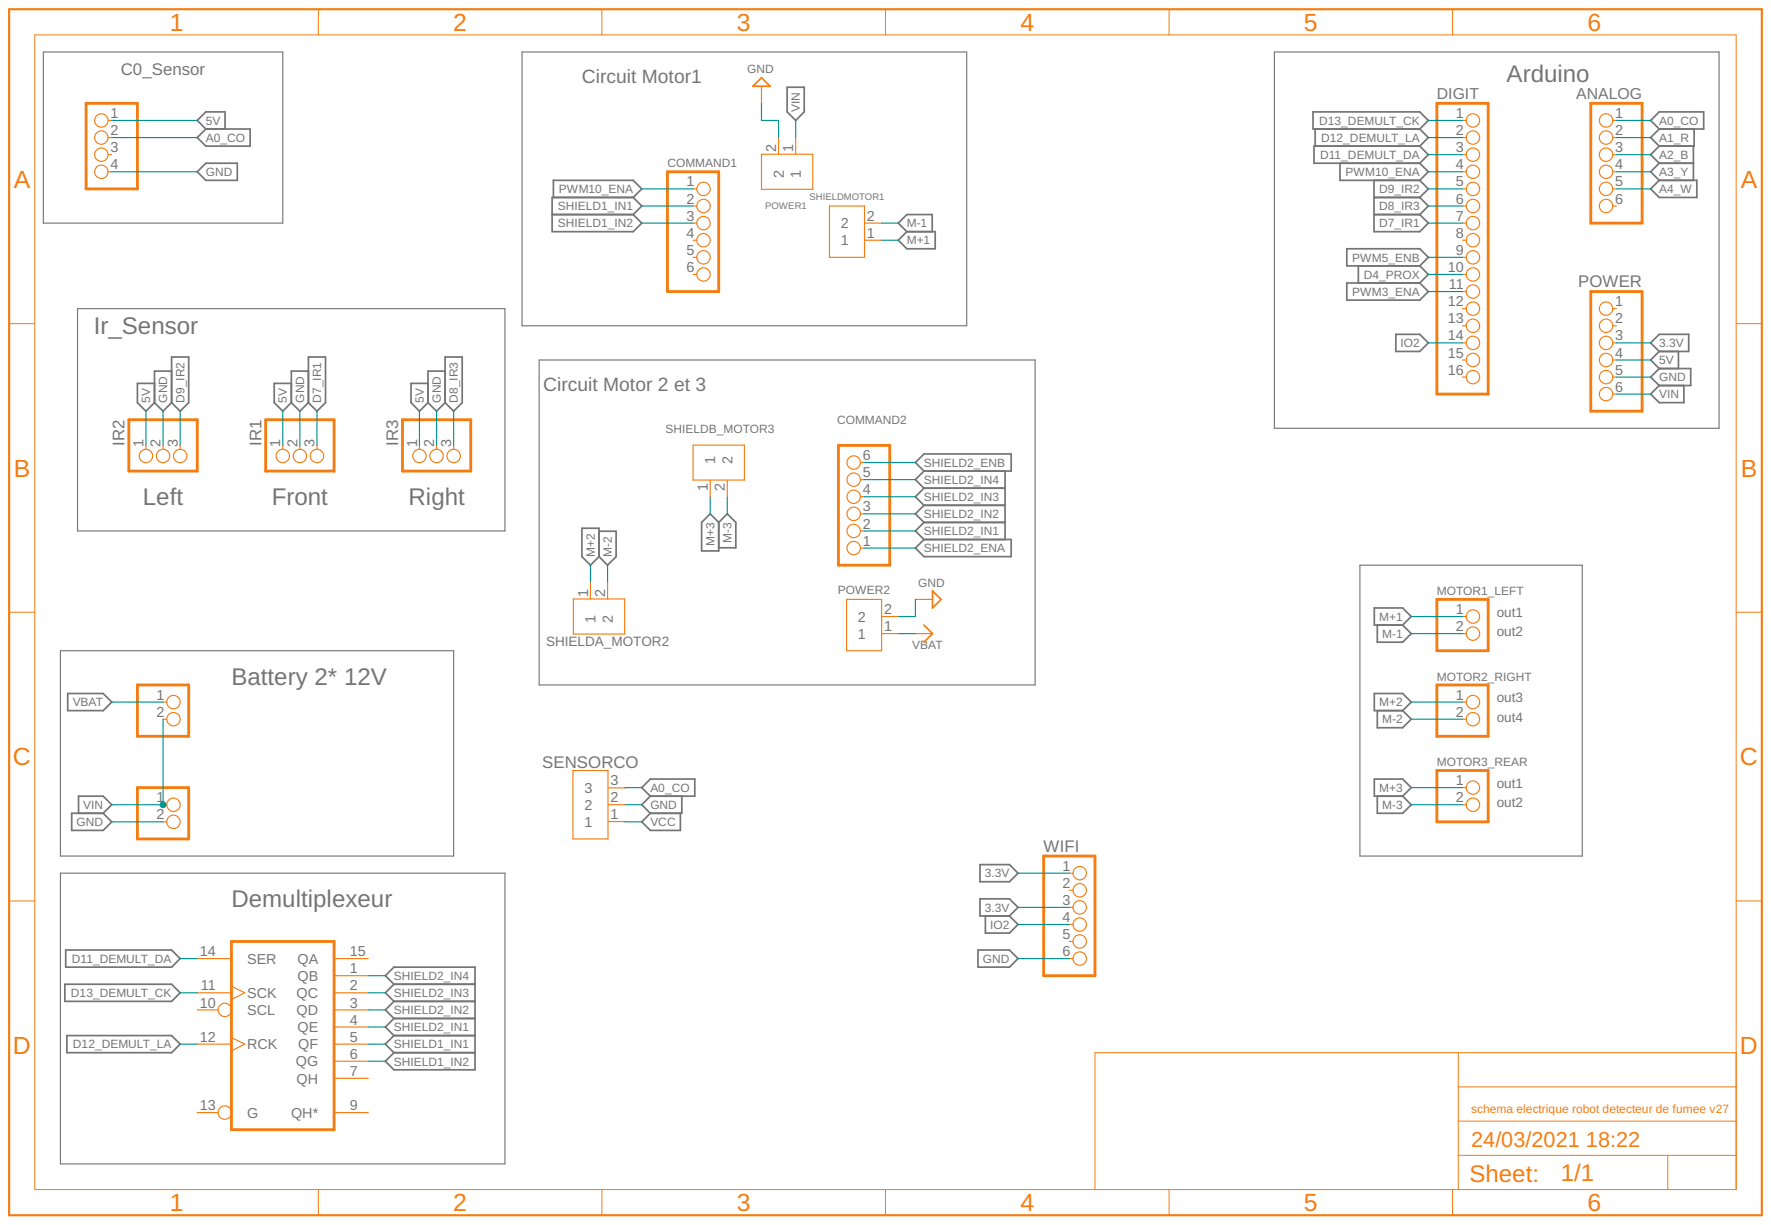
[picture p33: page 1]
