hugo38rodrigues/GazSensorRobot/src/Robot/Sensor_Capteur_global.h

#ifndef SENSOR_CAPTEUR_GLOBAL_H
#define SENSOR_CAPTEUR_GLOBAL_H

#include <QtCore/qglobal.h>

#if defined(SENSOR_CAPTEUR_LIBRARY)
#  define SENSOR_CAPTEUR_EXPORT Q_DECL_EXPORT
#else
#  define SENSOR_CAPTEUR_EXPORT Q_DECL_IMPORT
#endif

#endif // SENSOR_CAPTEUR_GLOBAL_H
