hugo38rodrigues/GazSensorRobot/src/Robot/Robot_global.h

#ifndef ROBOT_GLOBAL_H
#define ROBOT_GLOBAL_H

#include <QtCore/qglobal.h>

#if defined(ROBOT_LIBRARY)
#  define ROBOT_EXPORT Q_DECL_EXPORT
#else
#  define ROBOT_EXPORT Q_DECL_IMPORT
#endif

#endif // ROBOT_GLOBAL_H
