hugo38rodrigues/GazSensorRobot/(commit log)

2020-10-14 test de la camera
2020-10-17 ajout du cahier des charges
2020-10-17 suppression mauvais cahier des charges
2020-10-18 mis à jour de l'organigramme.
2020-10-18 ajoute du cahier des charges et du code pour IR.
2020-11-04 cahier des charges a jour
    cahier des charges a jour
2020-11-04 marche avec openmv+camera IRL
2020-11-22 ajout du code et modification du cahier de l'organigramme
2020-11-22 ajout du code pour la mobilite du robot
2020-11-24 tests caméra pour arduino
2020-11-24 code capteurs fin de course à mettre dans le programme pincipal et a ajuster au besoin
2020-11-24 supression de l'ancien code moteur et ajout du code obstacle à finir
2020-12-17 ajoute des commentaires
2021-01-05 apport de la diapo de presentation
2021-01-05 uptade de la presentatiton
2021-02-08 ajoute du code C0 et maj de la presentation
2021-02-09 ajout datasheet MQ7 et traduction des com
2021-02-14 regroupement des tests dans d'un repertoire
2021-02-14 ajout des fichier dans la datasheet
2021-02-14 ajout du schema de cablage
2021-02-19 ajout de la classe capteur et jail ainsi que ajout des fonctions capteur infra dans le code main
2021-02-20 ajout de la librairie speed box
2021-02-21 suppression des arrets moteur dans la speedbox
2021-02-21 ajout de prog de tests
2021-02-21 suppresion du commentaire pour la jail
2021-03-03 ajout du tableau des I/O du systeme
2021-03-03 ajout de la classe capteur CO
2021-03-06 suppression du tableau des I/O
2021-03-10 fix compilation error in COSensor
    [cosensor.cpp, cosensor.h]
2021-03-14 add Arduino Cam OV7670 doc and links
2021-03-20 schema de cablage ajout du composant wifi et Co
2021-03-20 correction des commandes G/D
    [SpeedBox.cpp]
2021-03-20 rajout de tout le code jail + co
2021-03-20 changement de destinataire
2021-03-21 modification du delay de la boucle
2021-03-21 ajout de la classe capteude contacte
2021-03-21 modification de l'adressage des moteurs
2021-03-21 ajout du capteur de contacte
2021-03-24 Create Diagramme_de_gantt.png
    Diagramme de gantt
2021-03-25 modification des schemas et de la lisibilite
2021-03-27 modification de la vitesse de rotation des moteurs et boucle true pour stop le robot lors de la detection de CO
2021-03-27 modification de la distance de détection
2021-03-27 ajout d'un compteur pour gére le comptage de capteur pour activer la prison
2021-03-28 ajout du diagramme de Gant
    [diagramme de Gant.xlsx]
2021-03-28 ajout des tipons de la carte alimentation et 74hc592
2021-03-28 supression de fichier corompus
2021-03-29 modification de la description de la classe
2021-03-29 mise à jour des annexes
2021-03-29 ajout de la presentation du robot
2021-03-29 mise à jour rapport + presentation + gantt
    [diagramme de Gant.xlsx]
2021-03-30 refactor folders
    [diagramme de Gant.xlsx]
2021-03-30 ajout des video de test du robot
